tudorbaranai/esp32-wifi-rc-car/(commit log)

2025-11-02 Initial commit: ESP32 WiFi-controlled car with safety features
    - Web-based joystick interface for intuitive control
    - L298N motor driver with PWM speed control
    - Safety timeout: automatic stop after 500ms without commands
    - Continuous heartbeat system: 100ms updates while active
    - Touch-friendly responsive design for mobile devices
    - Motor threshold tuning for smooth operation
    - Comprehensive README with setup instructions
2025-11-07 Add optimized WebSocket architecture with external controller
    Major improvements:
    - WebSocket-only communication (removed HTTP server, saved ~18KB flash)
    - External controller.html (GitHub Pages compatible)
    - Station mode with WiFiManager (joins home WiFi)
    - mDNS support (esp32-car.local)
    - Memory optimizations (char[] instead of String)
    - Improved latency (~50ms vs ~100ms)
    - Inverted joystick direction (forward = forward)
    New files:
    - controller.html: Standalone web-based joystick controller
    - SETUP_GUIDE.md: Comprehensive setup and hosting guide
    Updated files:
    - Larisuta_masina_v4.ino: WebSocket-only, WiFiManager, mDNS, optimizations
    - README.md: Updated documentation with new features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
2025-11-26 Add 360-degree analog joystick control
    - Implement smooth curve-to-spin transition algorithm
    - Forward + turn = car curves (both wheels forward)
    - Pure left/right = spin in place (tank steering)
    - Add CURVE_STEEPNESS parameter for tuning (default 2.0)
    - Fix turn direction inversion
    - Update NOTES.md with session 2 documentation
2025-11-27 Add HC-SR04 test code and update session notes
    - Added HC_SR04_Test folder with ultrasonic sensor test sketch
    - Documented Session 4: USB port detection troubleshooting (unresolved)
    - Recorded all troubleshooting steps attempted for future reference
2025-11-28 Add autonomous obstacle avoidance driving mode
    - New Autonomous_drive project with smart escape logic
    - HC-SR04 sensor integration (TRIG=GPIO13, ECHO=GPIO14)
    - State machine: Forward → Stop → Reverse → Turn → Check
    - Alternates turn direction after 3 failed attempts
    - Updated HC_SR04_Test with cleaner output
    - Comprehensive session notes for AI context
    [Autonomous_drive.ino, HC_SR04_Test.ino]
2025-12-04 Add proportional speed control and 6x AA battery support
    - Implement linear proportional joystick control (like real RC controller)
    - Add MAX_PWM_OUTPUT limit for indoor testing (80-110 PWM range)
    - Reduce dead zone to 8px for immediate response
    - Document 6x AA series wiring (10.2V measured)
    - Update session notes with battery and speed tuning details
2026-11-03 Move the remote-control sketch into Remote_drive/
    Arduino needs a sketch to sit in a folder with the same name. Giving it its own folder, like Autonomous_drive/, keeps that true whatever the repo folder is called, and drops the old nickname from the file name.
2026-11-03 Rewrite README around what the car does and why
    Plain headings, numbers that match the code, the reasons behind the main design choices, wiring for both sketches, and an honest Known limitations section.
2026-11-06 Ignore PlatformIO builds and secrets.h
    .pio/ is PlatformIO's build folder and secrets.h is where Arduino sketches
    usually keep Wi-Fi passwords, so neither can be committed by accident.
